eldar6776/Extruder-Raw-Material-Vacuum-Transport-Controller/README.md

# Extruder-Raw-Material-Vacuum-Transport-Controller
Extruder Raw Material Vacuum Transport Controller (PIC16F1517 + PIC12C508)
