eldar6776/Extruder-Raw-Material-Vacuum-Transport-Controller/doc/Kodovi grešaka.png

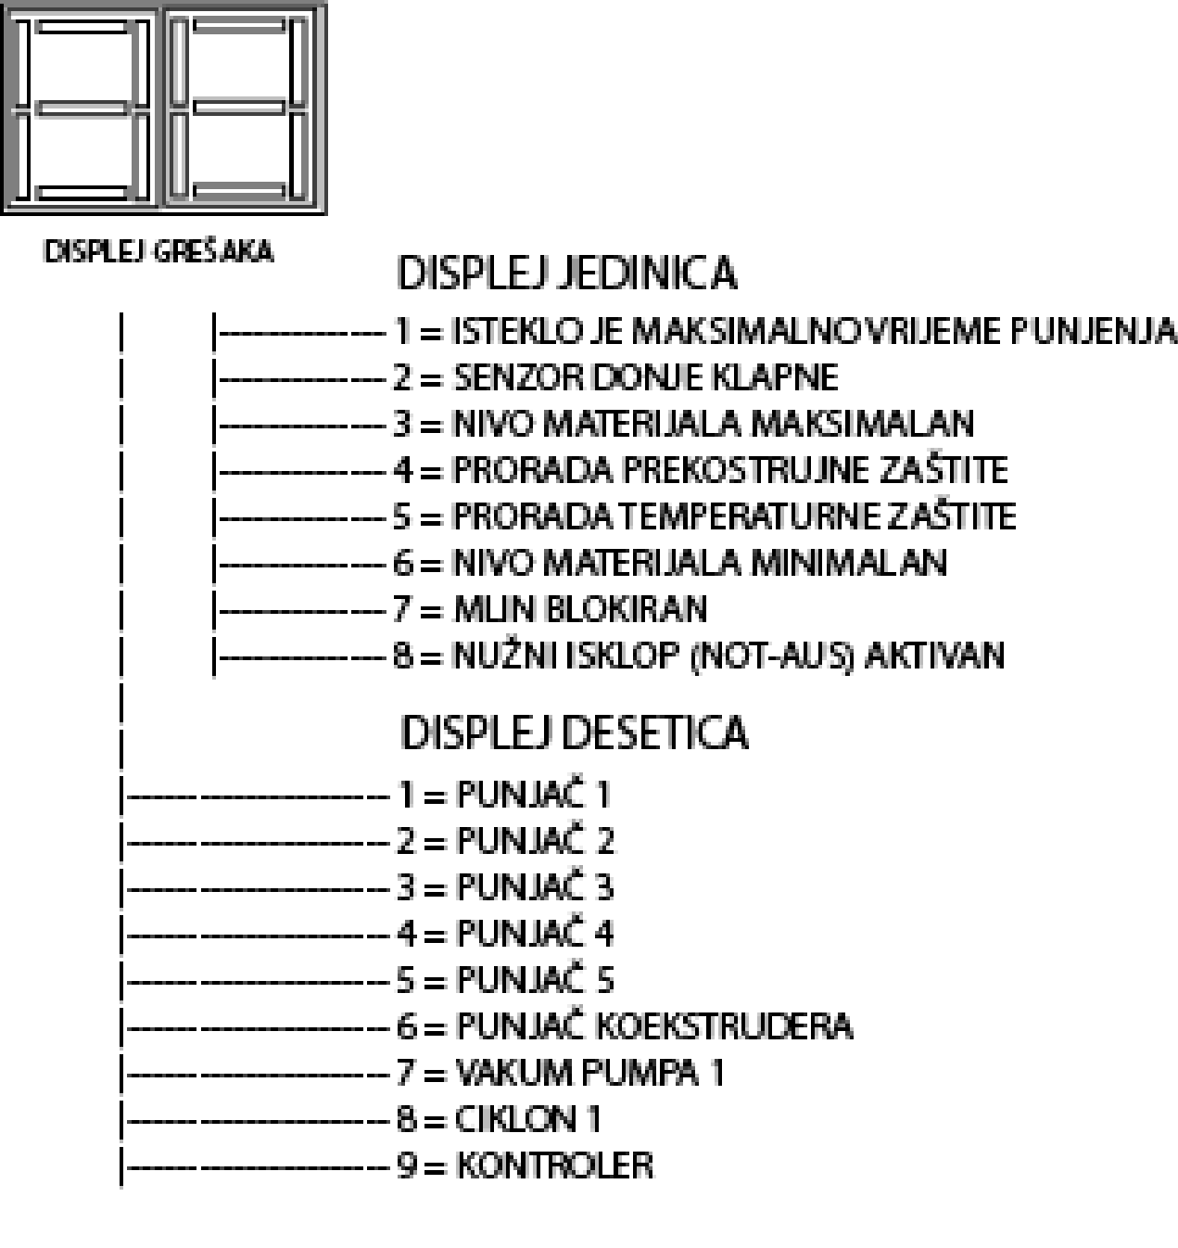
doc/Kodovi grešaka.png
