eldar6776/Extruder-Raw-Material-Vacuum-Transport-Controller/doc/Raspored tastera i indikatora komande punjača.png

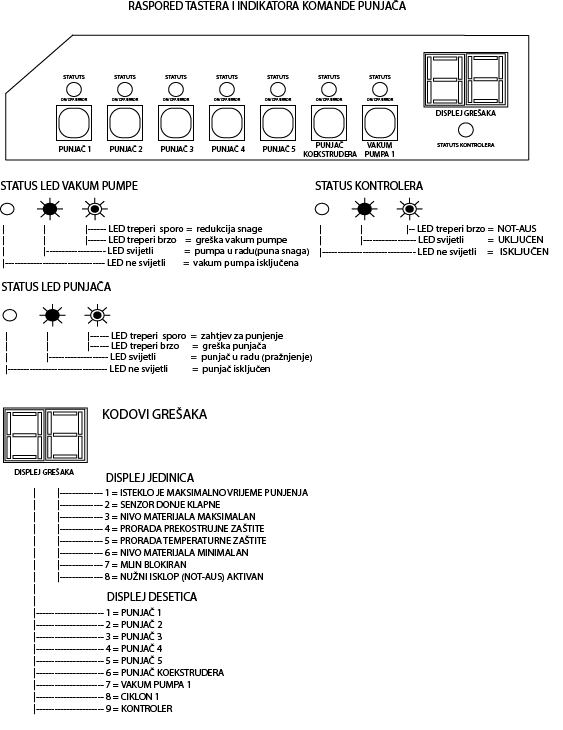
doc/Raspored tastera i indikatora komande punjača.png
