eldar6776/Extruder-Raw-Material-Vacuum-Transport-Controller/doc/TL494_converter.jpg

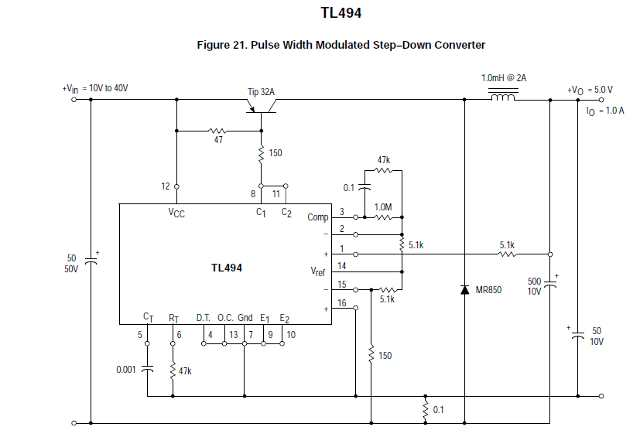
doc/TL494_converter.jpg
