eldar6776/Extruder-Raw-Material-Vacuum-Transport-Controller/(list of files, cad)

Other CAD files:
fw/ERROR_DISPLAY.X/dist/default/production/ERROR_DISPLAY.X.production.obj
fw/ERROR_DISPLAY.X/l.obj
fw/KONTROLER_TRANSPORTA.X/dist/default/production/KONTROLER_TRANSPORTA.X.production.obj
fw/KONTROLER_TRANSPORTA.X/l.obj
