eldar6776/Extruder-Raw-Material-Vacuum-Transport-Controller/DC SUPPLY.PDF

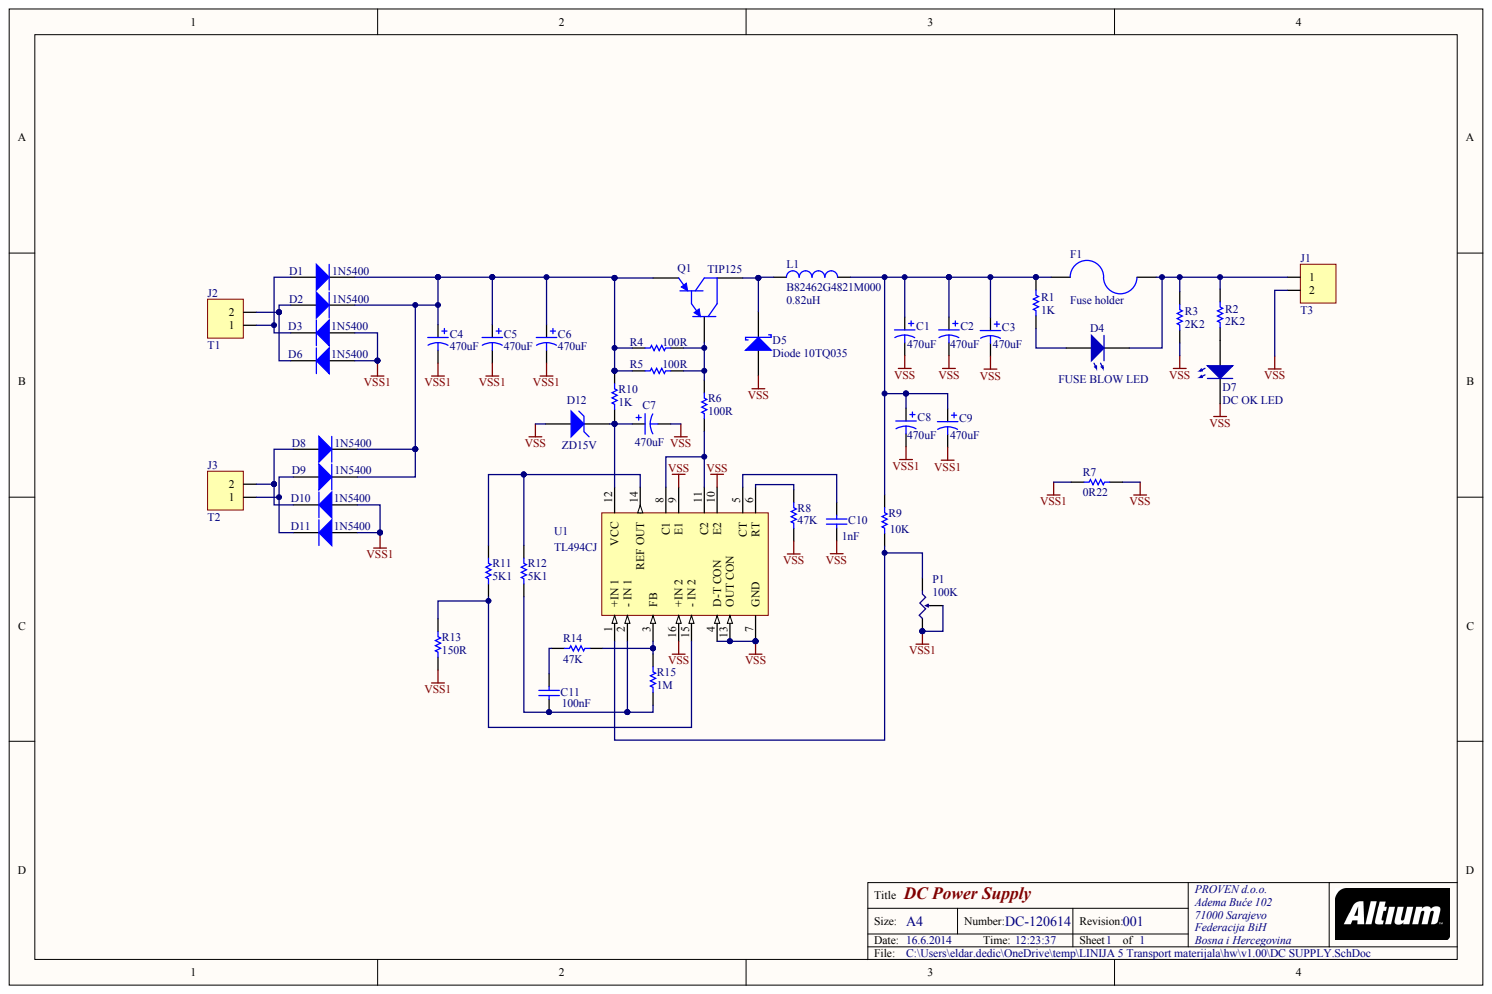
[picture p5: page 1]

DC Power Supply Title | PROVEN d.o.o. Adema Bu ć e 102 71000 Saraje v o Federacija BiH Bosna i Herc egovina

A4 Siz e : | DC-120614 Number: | 001 Revision:
Date : 16.6.2014 Time : 12:23:37 | | She e t 1 of 1

C:\Users\eldar.dedic\OneDrive\temp\LINIJA 5 Transport materijala\hw\v1.00\DC SUPPLY.SchDoc
File

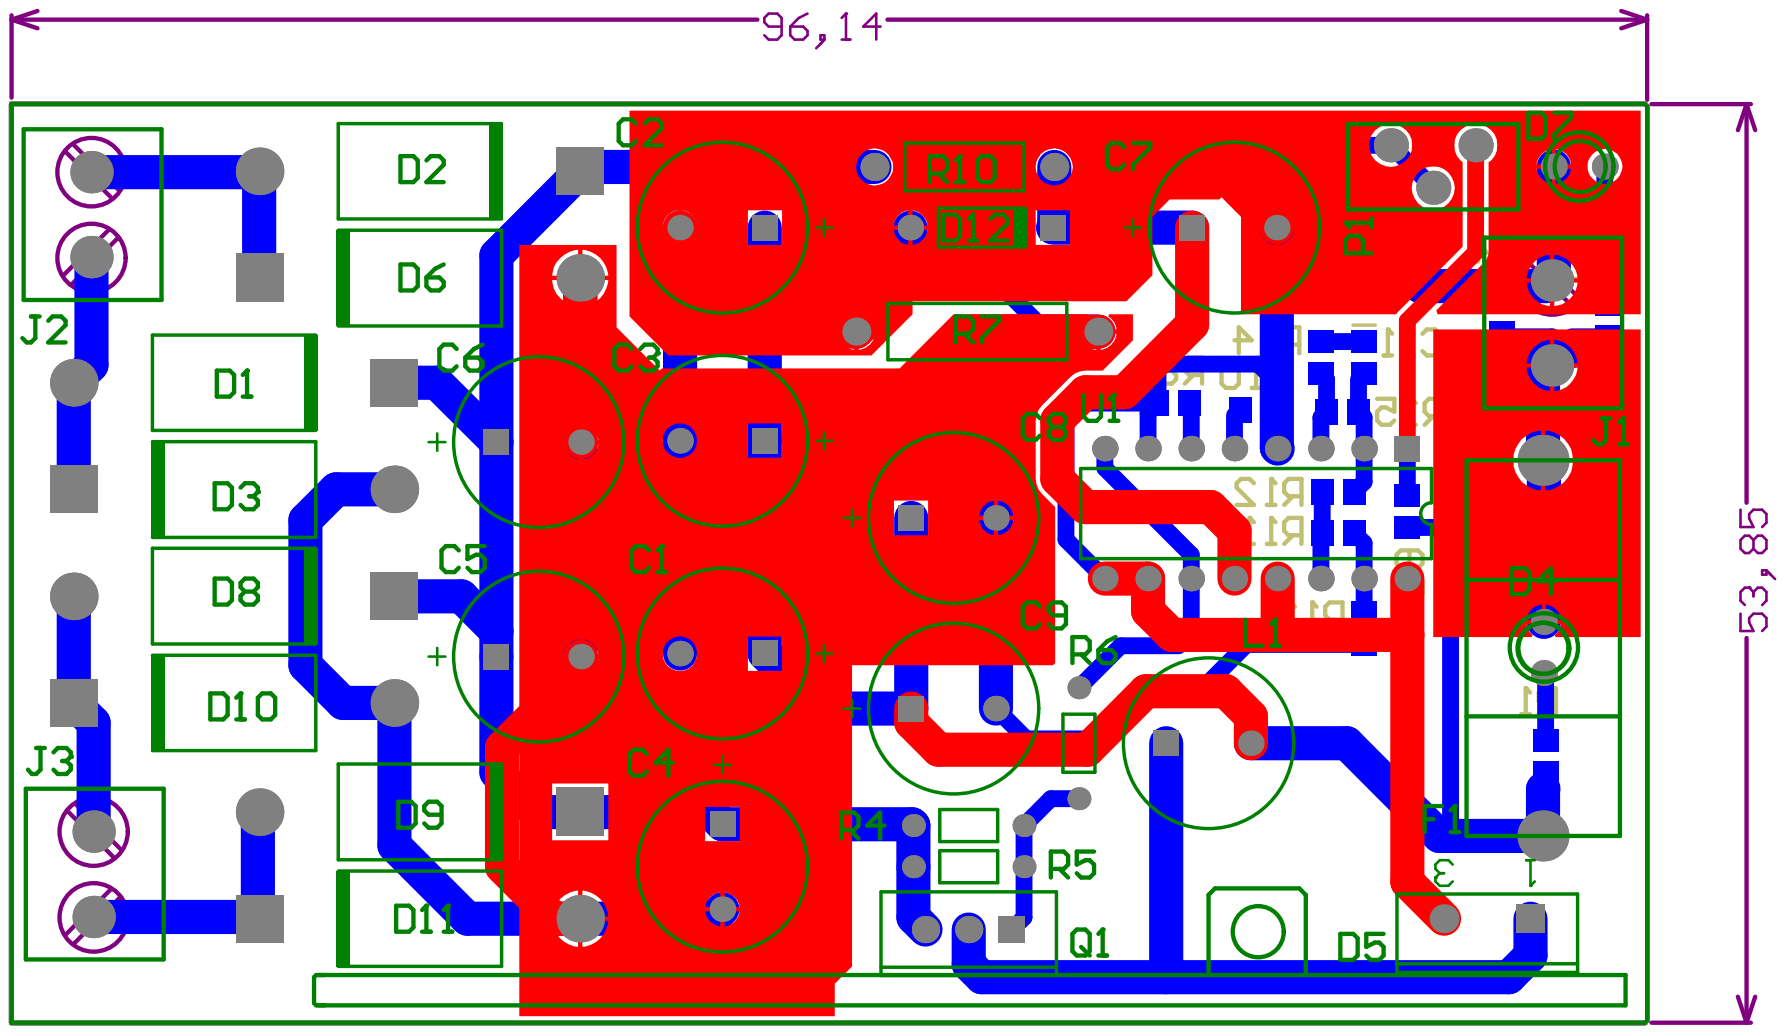
[picture p6: page 2]
