eldar6776/Extruder-Raw-Material-Vacuum-Transport-Controller/doc/Dodatni moduli.pdf

P704 | 1
P702 | 1

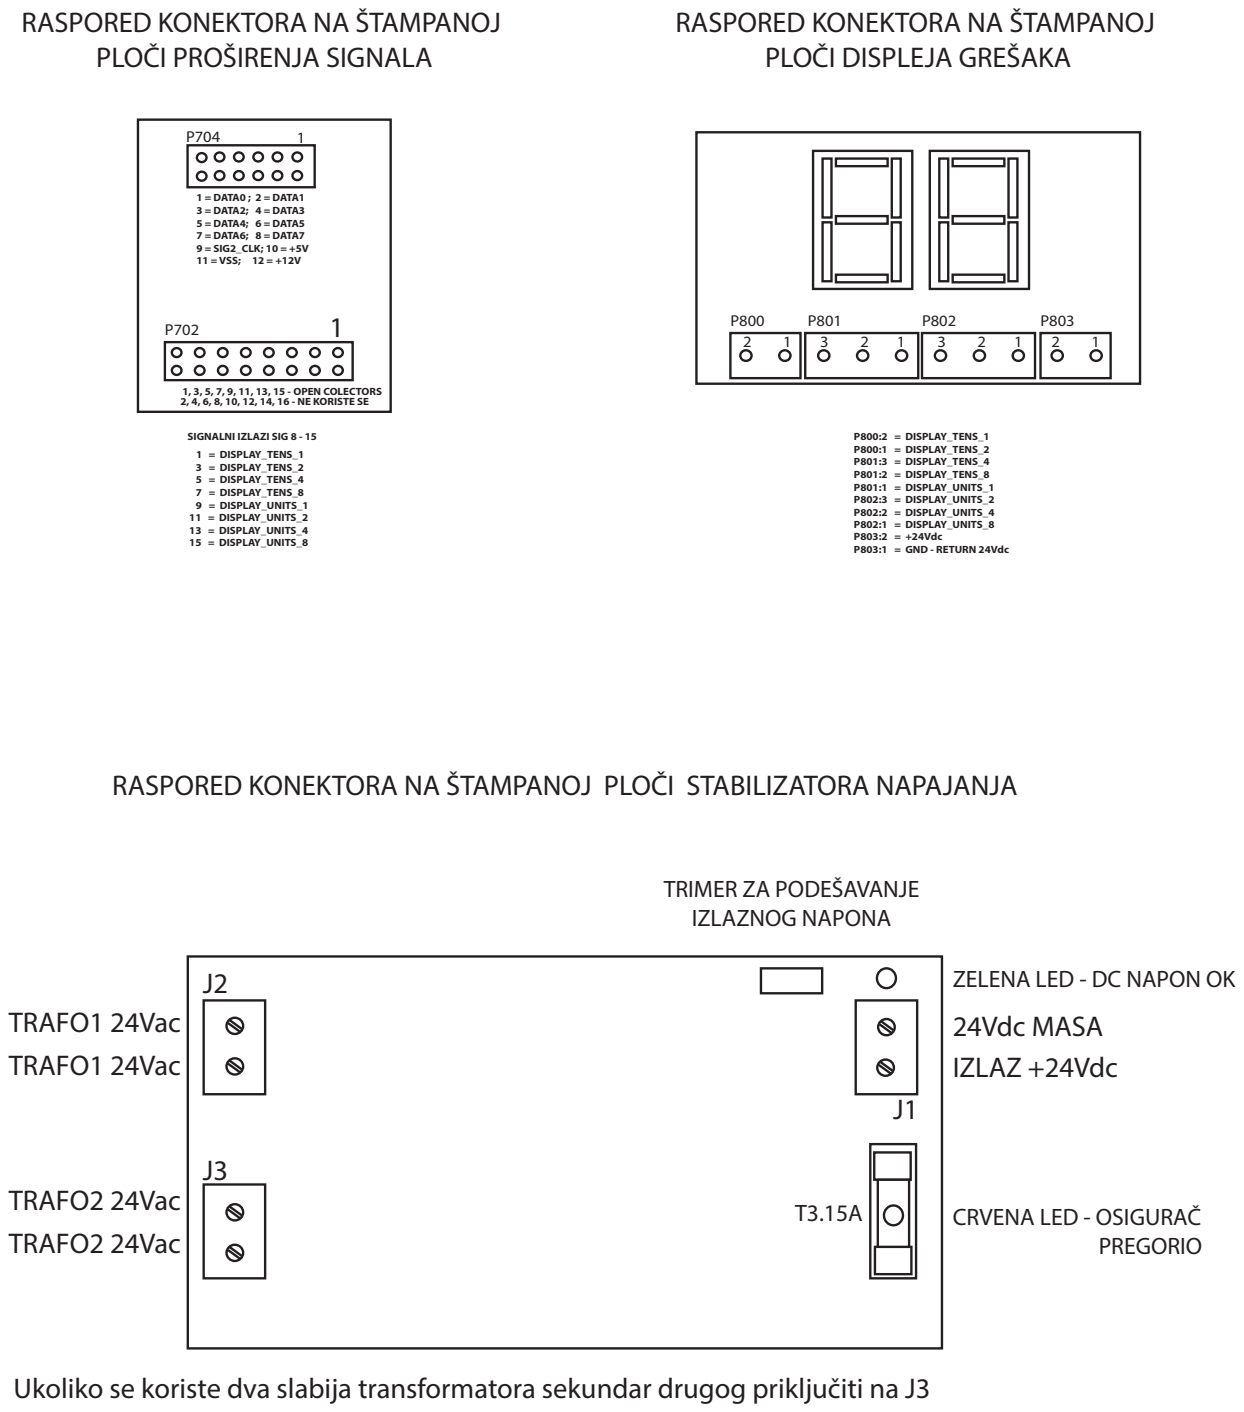
[picture p7: page 1]
1 = DISPLAY_TENS_1; 3 = DISPLAY_TENS_2; 5 = DISPLAY_TENS_4; 7 = DISPLAY_TENS_8; 9 = DISPLAY_UNITS_1; 11 = DISPLAY_UNITS_2; 13 = DISPLAY_UNITS_4; 15 = DISPLAY_UNITS_8; 1 = DATA0 ; 2 = DATA1; 3 = DATA2; 4 = DATA3; 5 = DATA4; 6 = DATA5; 7 = DATA6; 8 = DATA7; 9 = SIG2_CLK; 10 = +5V; 11 = VSS;; P800:2 = DISPLAY_TENS_1; P800:1 = DISPLAY_TENS_2; P801:3 = DISPLAY_TENS_4; P801:2 = DISPLAY_TENS_8; P801:1 = DISPLAY_UNITS_1; P802:3 = DISPLAY_UNITS_2; P802:2 = DISPLAY_UNITS_4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

RASPORED KONEKTORA NA ŠTAMPANOJ
PLOČI PROŠIRENJA SIGNALA

PLOČI DISPLEJA GREŠAKA

1, 3, 5, 7, 9, 11, 13, 15 - OPEN COLECTORS
2, 4, 6, 8, 10, 12, 14, 16 - NE KORISTE SE

SIGNALNI IZLAZI SIG 8 - 15

RASPORED KONEKTORA NA ŠTAMPANOJ PLOČI STABILIZATORA NAPAJANJA

TRIMER ZA PODEŠAVANJE
IZLAZNOG NAPONA

ZELENA LED - DC NAPON OK
24Vdc MASA
IZLAZ +24Vdc

CRVENA LED - OSIGURAČ

Ukoliko se koriste dva slabija transformatora sekundar drugog priključiti na J3
