eldar6776/Extruder-Raw-Material-Vacuum-Transport-Controller/doc/Raspored tastera i indikatora komande punjača.pdf

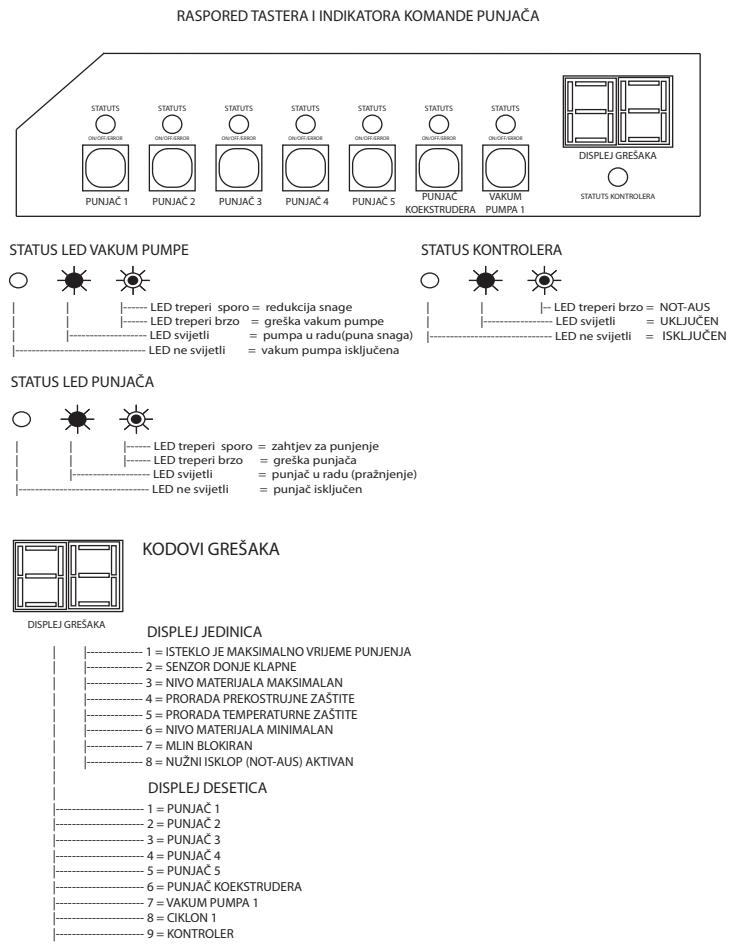
[picture p8: page 1]
PUNJAČ 1; PUNJAČ 2; PUNJAČ 3; PUNJAČ 4; PUNJAČ 5; PUNJAČ; KOEKSTRUDERA; VAKUM PUMPA 1; DISPLEJ GREŠAKA; STATUTS; STATUTS KONTROLERA; ON/OFF/ERROR; |-------------- 1 = ISTEKLO JE MAKSIMALNO VRIJEME PUNJENJA; |-------------- 2 = SENZOR DONJE KLAPNE; |-------------- 3 = NIVO MATERIJALA MAKSIMALAN; |-------------- 4 = PRORADA PREKOSTRUJNE ZAŠTITE; |-------------- 5 = PRORADA TEMPERATURNE ZAŠTITE; |-------------- 6 = NIVO MATERIJALA MINIMALAN; |-------------- 7 = MLIN BLOKIRAN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

RASPORED TASTERA I INDIKATORA KOMANDE PUNJAČA

STATUS LED VAKUM PUMPE

STATUS LED PUNJAČA

------------------------------ LED ne svijetli = ISKLJUČEN
