eldar6776/Extruder-Raw-Material-Vacuum-Transport-Controller/doc/Aux_PCB_print.pdf

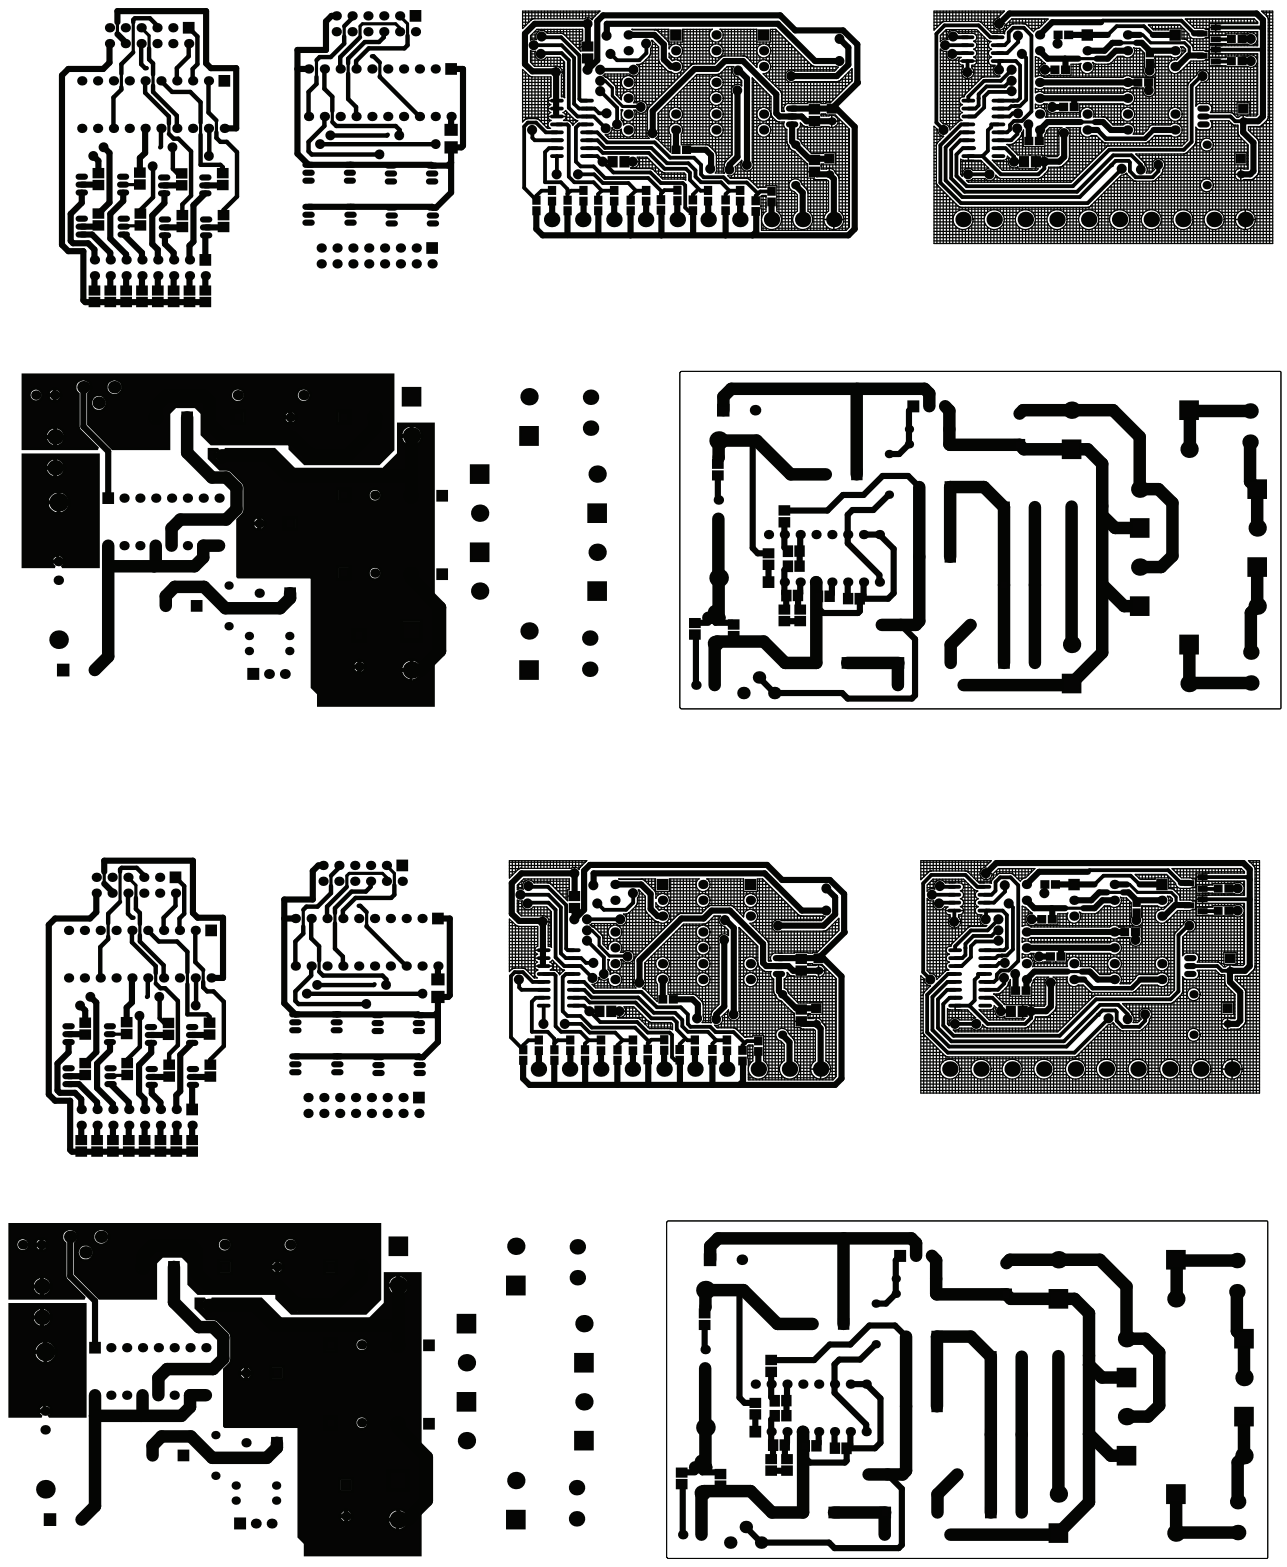
[picture p9: page 1]
