eldar6776/Extruder-Raw-Material-Vacuum-Transport-Controller/KOTROLER_TRANSPORTA.PDF

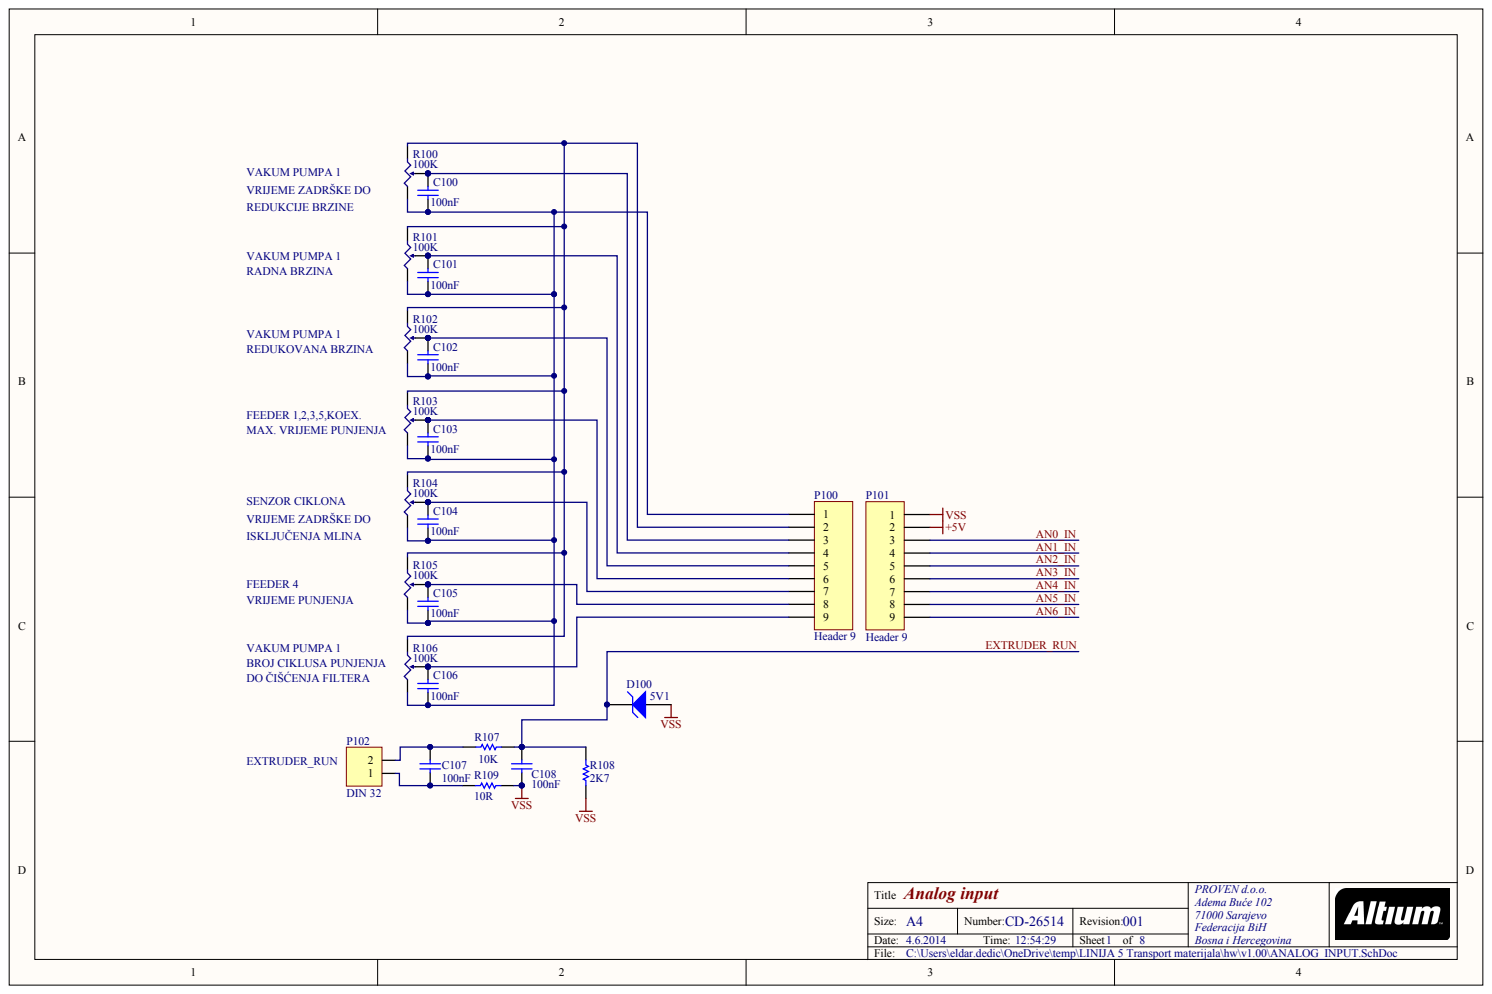
[picture p35: page 1]

Analog input Title | PROVEN d.o.o. Adema Bu ć e 102 71000 Saraje v o Federacija BiH Bosna i Herc egovina

A4 Siz e : | CD-26514 Number: | 001 Revision:
Date : 4.6.2014 Time : 12:54:29 | | She e t of 8

C:\Users\eldar.dedic\OneDrive\temp\LINIJA 5 Transport materijala\hw\v1.00\ANALOG_INPUT.SchDoc
File

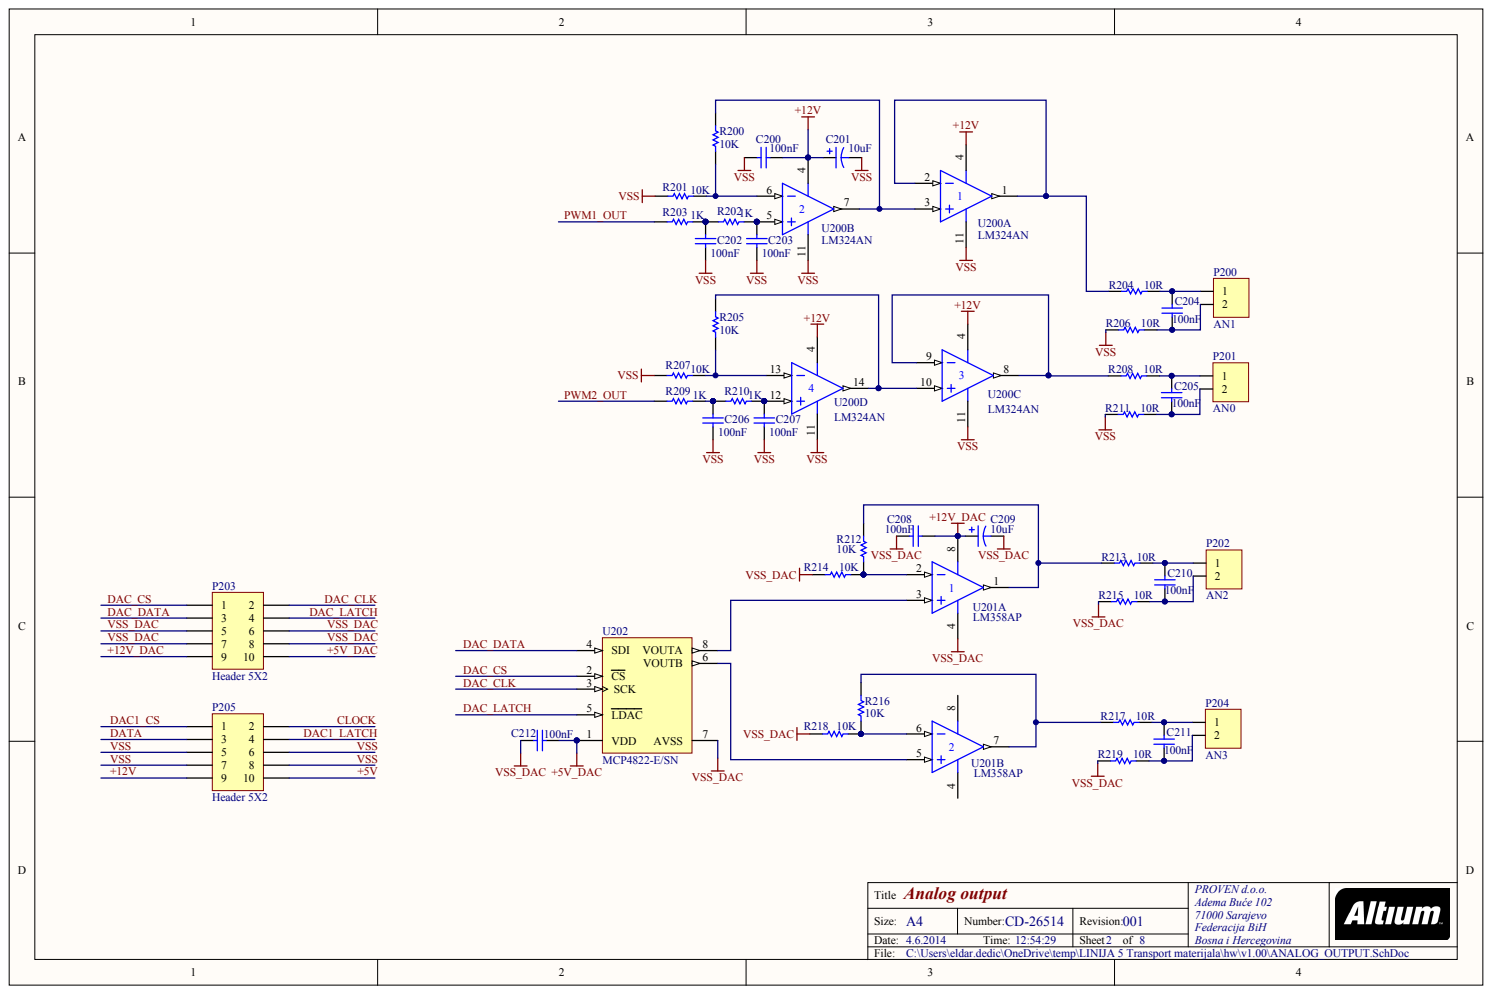
[picture p36: page 2]
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

A4 Siz e : | Number: | Revision:
Date : Time : | | She t of 8

C:\Users\eldar.dedic\OneDrive\temp\LINIJA 5 Transport materijala\hw\v1.00\ANALOG_OUTPUT.SchDoc
File

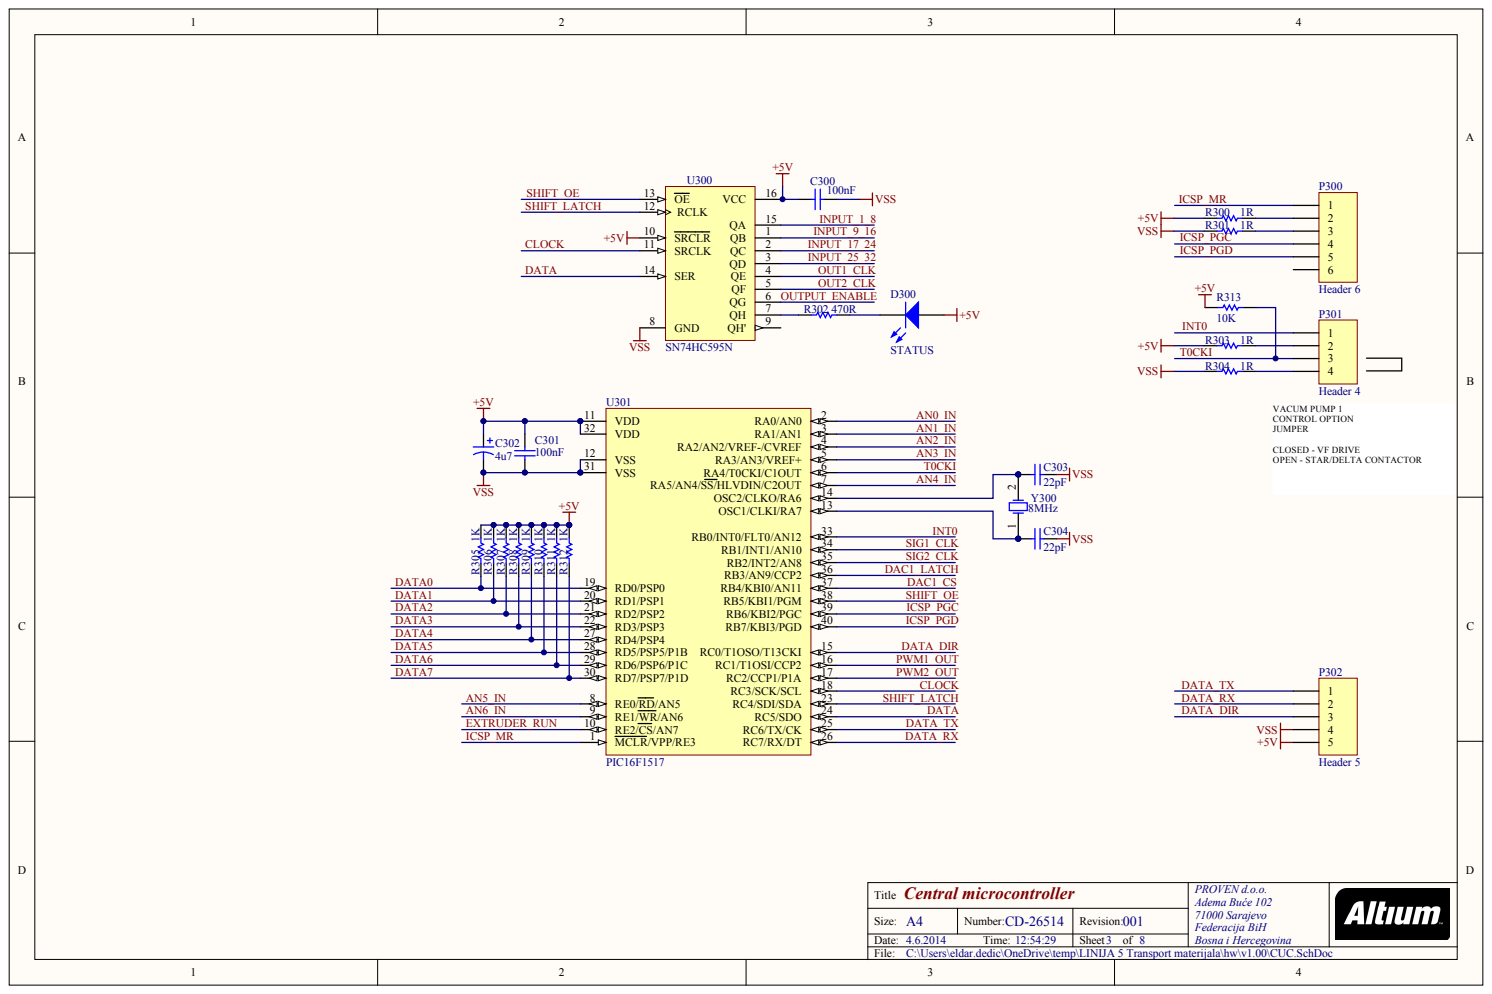
[picture p37: page 3]

VDD 32 | 3 AN1_IN
VSS 12 | 4 AN2_IN

VSS 31 | 6 T0CKI
RD0/PSP0 19 RD1/PSP1 20 RD2/PSP2 21 RD3/PSP3 22 RD4/PSP4 27 RD5/PSP5/P1B 28 RD6/PSP6/P1C 29 RD7/PSP7/P1D 30 RE2/CS/AN7 10 | 7 | AN4_IN

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

A4 Siz e : | Number: | Revision:
Date : Time : | | She t of 8

C:\Users\eldar.dedic\OneDrive\temp\LINIJA 5 Transport materijala\hw\v1.00\CUC.SchDoc
File

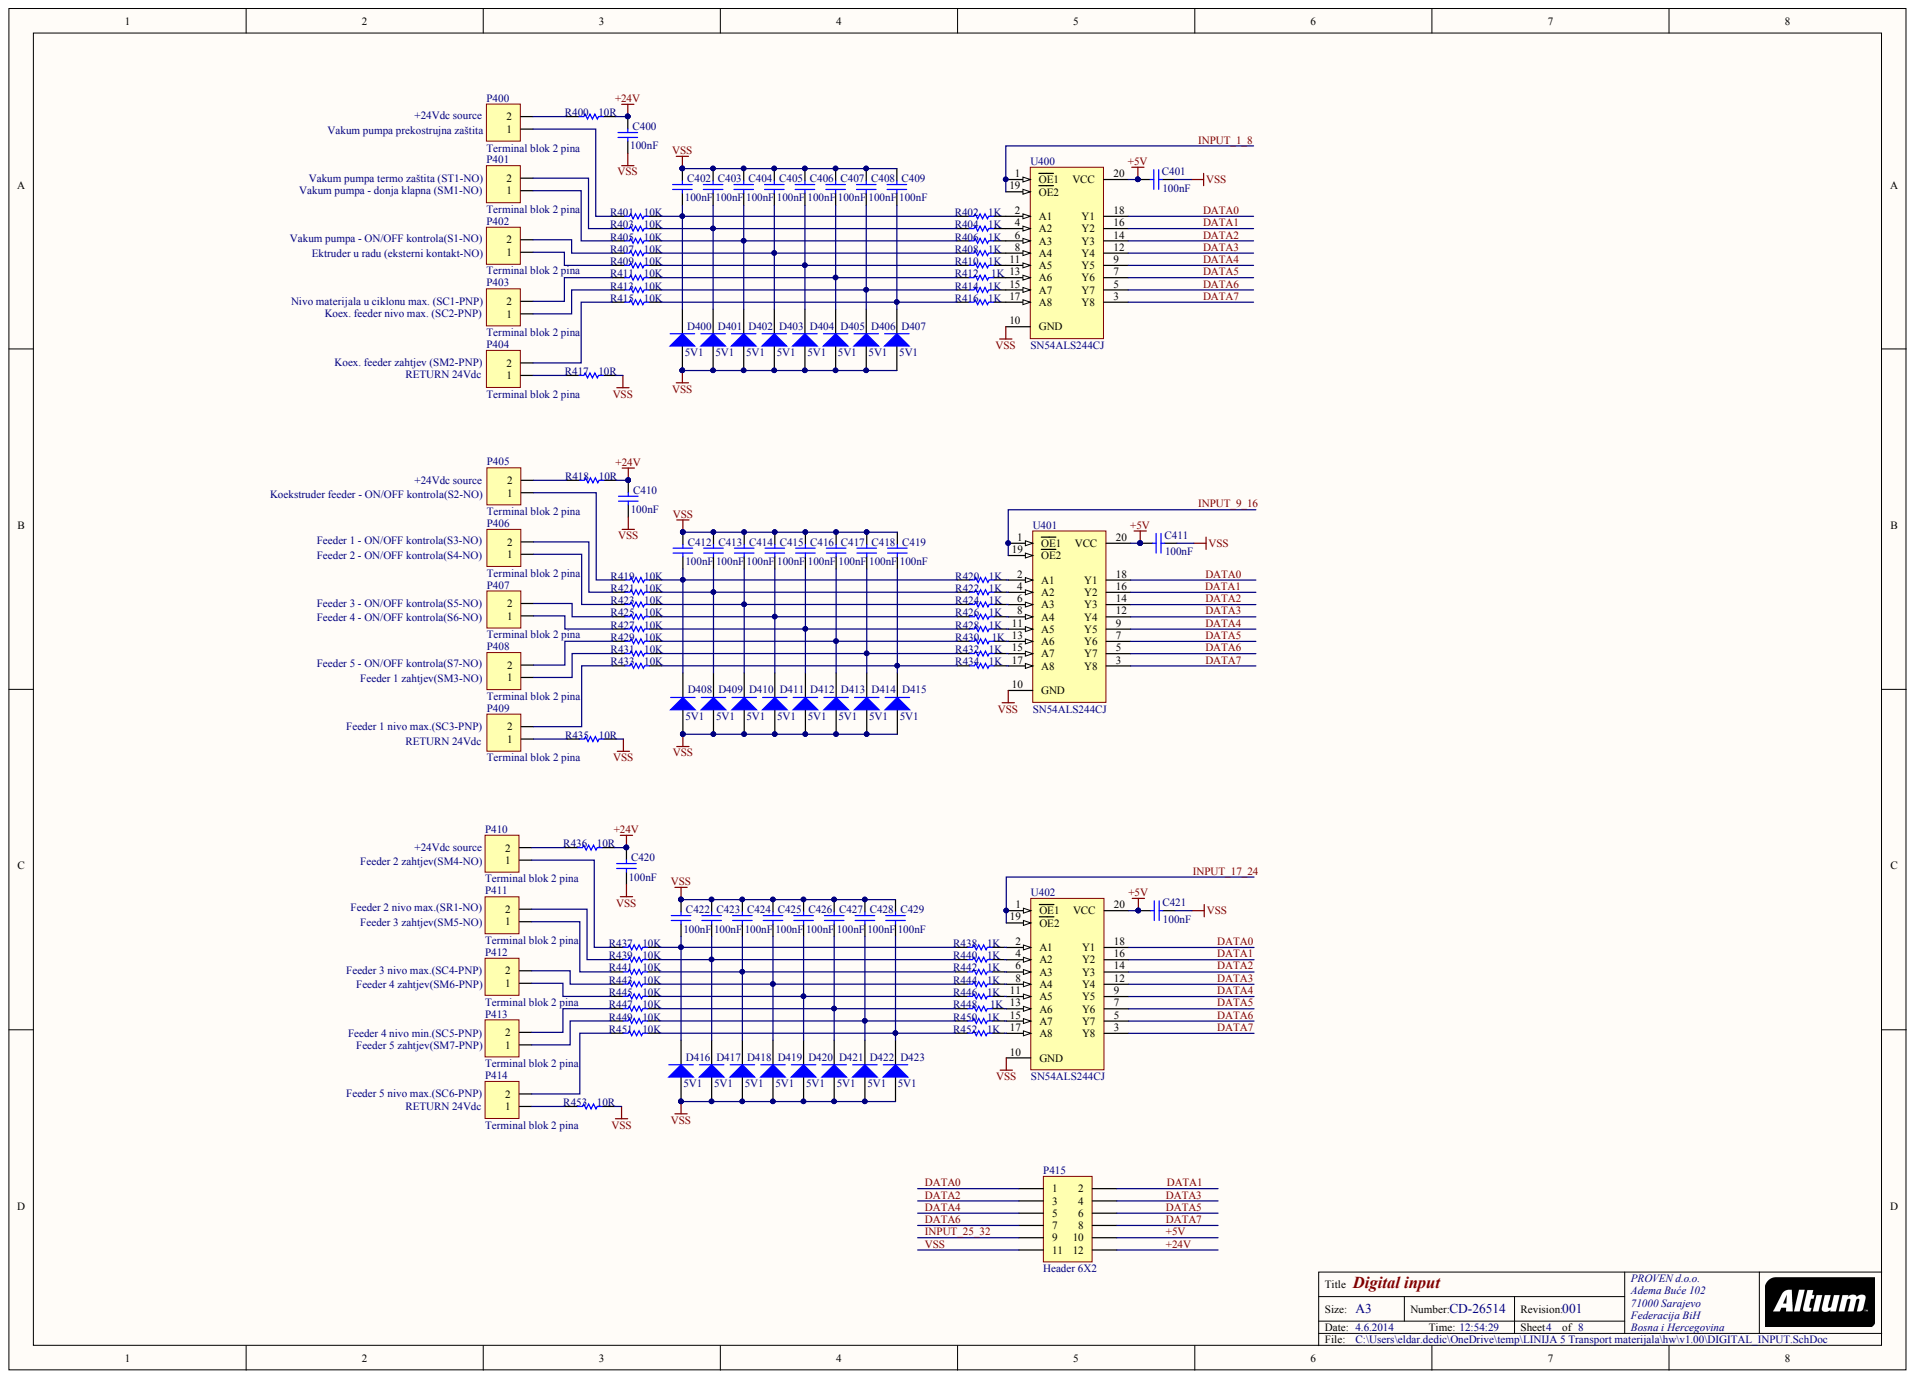
[picture p38: page 4]

Vakum pumpa prekostrujna zaštita

Vakum pumpa termo zaštita (ST1-NO)
Vakum pumpa - donja klapna (SM1-NO)

Vakum pumpa - ON/OFF kontrola(S1-NO)
Ektruder u radu (eksterni kontakt-NO)

Nivo materijala u ciklonu max. (SC1-PNP)

Koex. feeder nivo max. (SC2-PNP)

Koex. feeder zahtjev (SM2-PNP)

Koekstruder feeder - ON/OFF kontrola(S2-NO)

Feeder 1 - ON/OFF kontrola(S3-NO)
Feeder 2 - ON/OFF kontrola(S4-NO)

Feeder 3 - ON/OFF kontrola(S5-NO)
Feeder 4 - ON/OFF kontrola(S6-NO)

Feeder 5 - ON/OFF kontrola(S7-NO)

Feeder 1 nivo max.(SC3-PNP)

Feeder 3 nivo max.(SC4-PNP)
Feeder 4 zahtjev(SM6-PNP)

Feeder 4 nivo min.(SC5-PNP)
Feeder 5 zahtjev(SM7-PNP)

Feeder 5 nivo max.(SC6-PNP)

Title Digital input | PROVEN d.o.o. Adema Buće 102 71000 Sarajevo Federacija BiH Bosna i Hercegovina

Size: A3 | Number: CD-26514 | Revision: 001

Date: Time: | | Sheet of 8

C:\Users\eldar.dedic\OneDrive\temp\LINIJA 5 Transport materijala\hw\v1.00\DIGITAL_INPUT.SchDoc

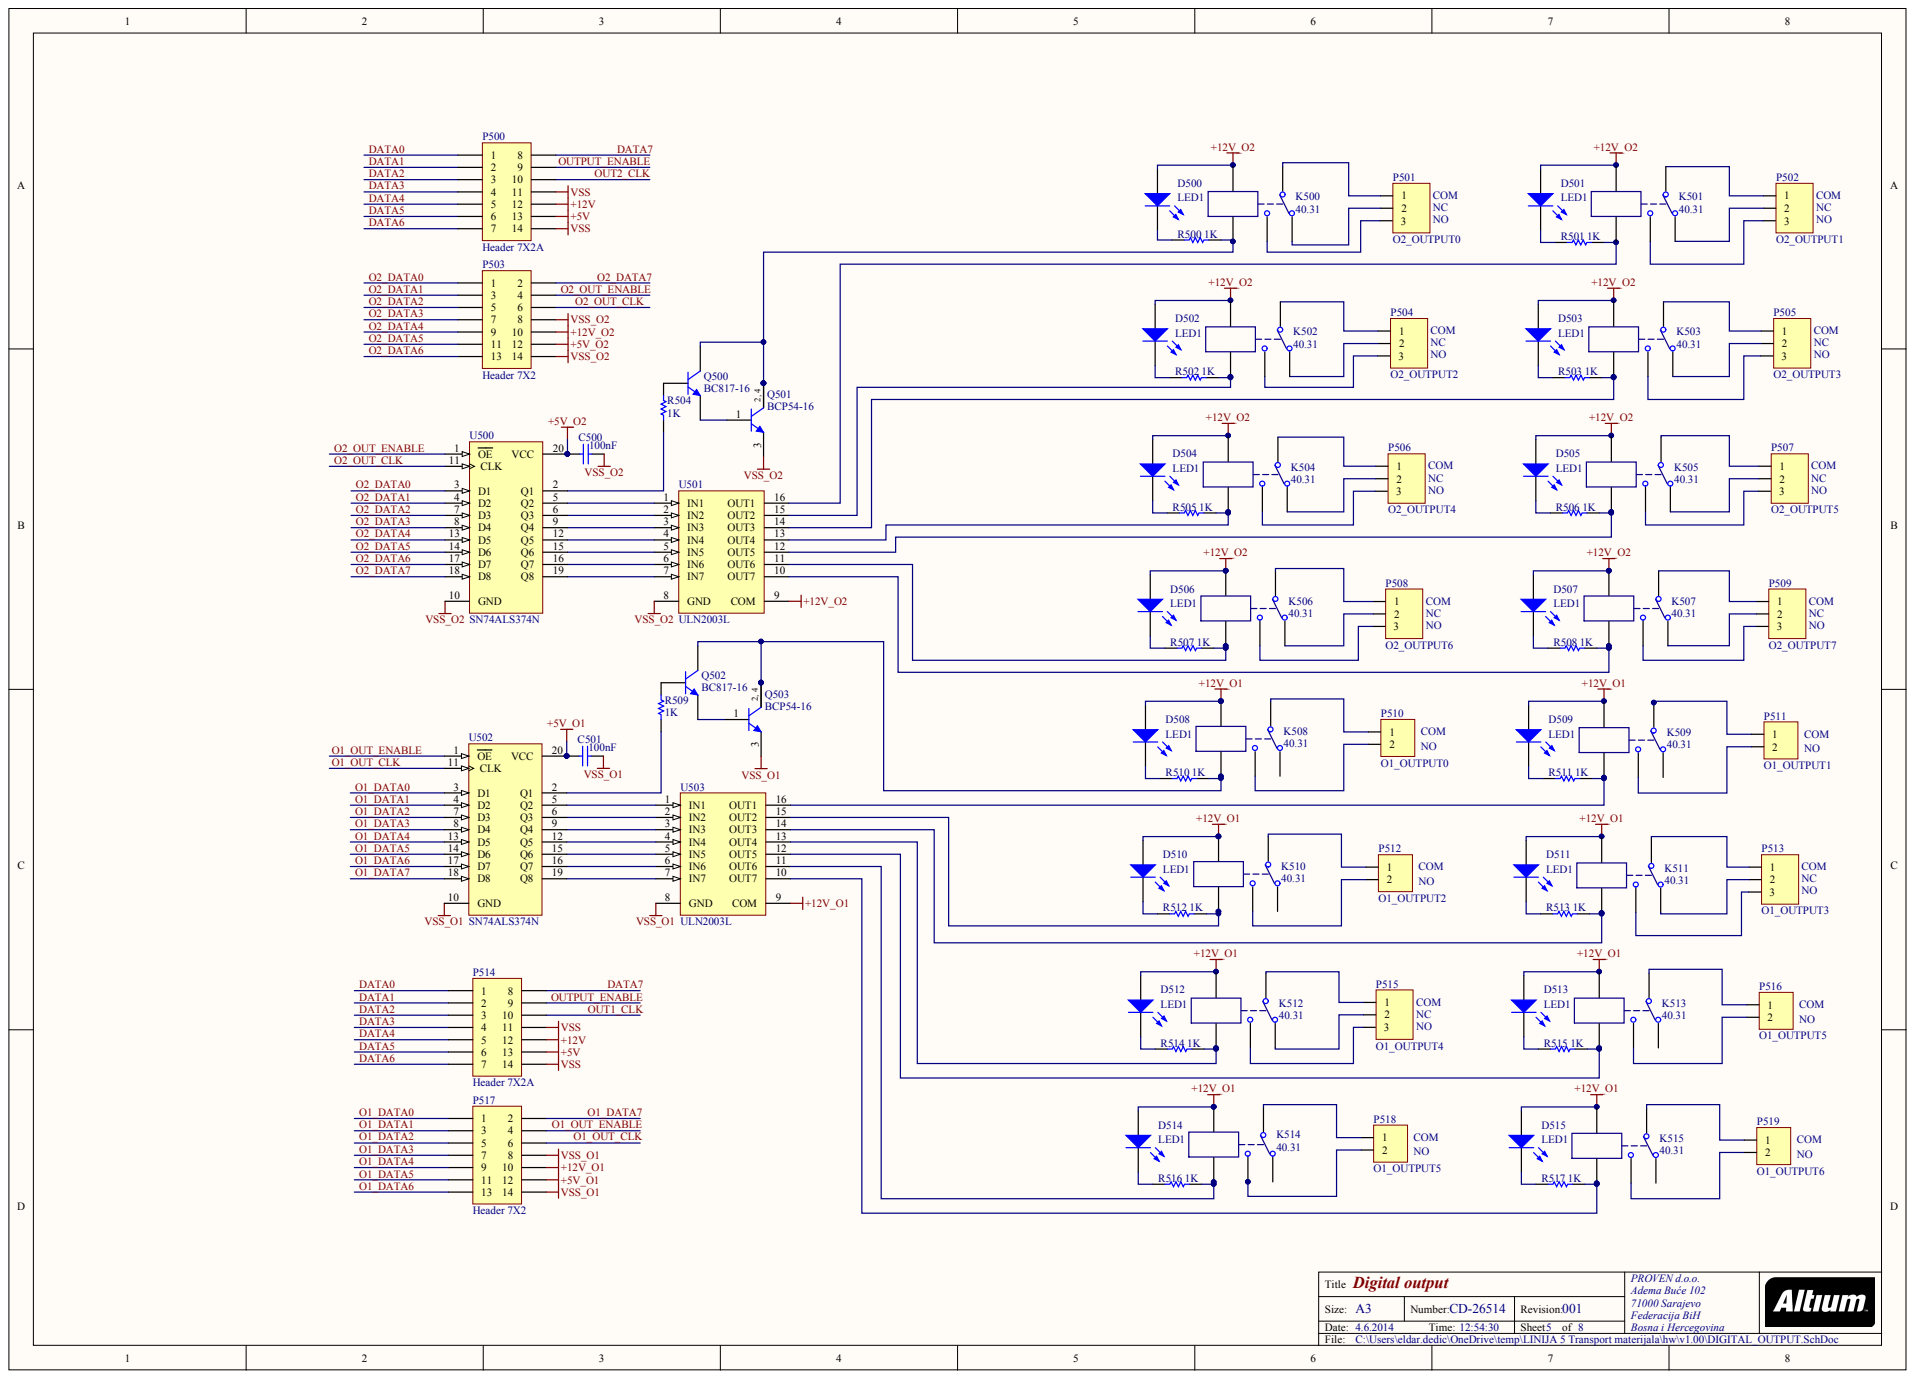
[picture p39: page 5]

Ti t l Digital output | PROVEN d.o.o. Adema Bu će 102 71000 Sarajevo Federacija BiH Bosna i Hercegovina

Size: A3 | Number: CD-26514 | Revision: 001

Ti me: | | Sheet of 8

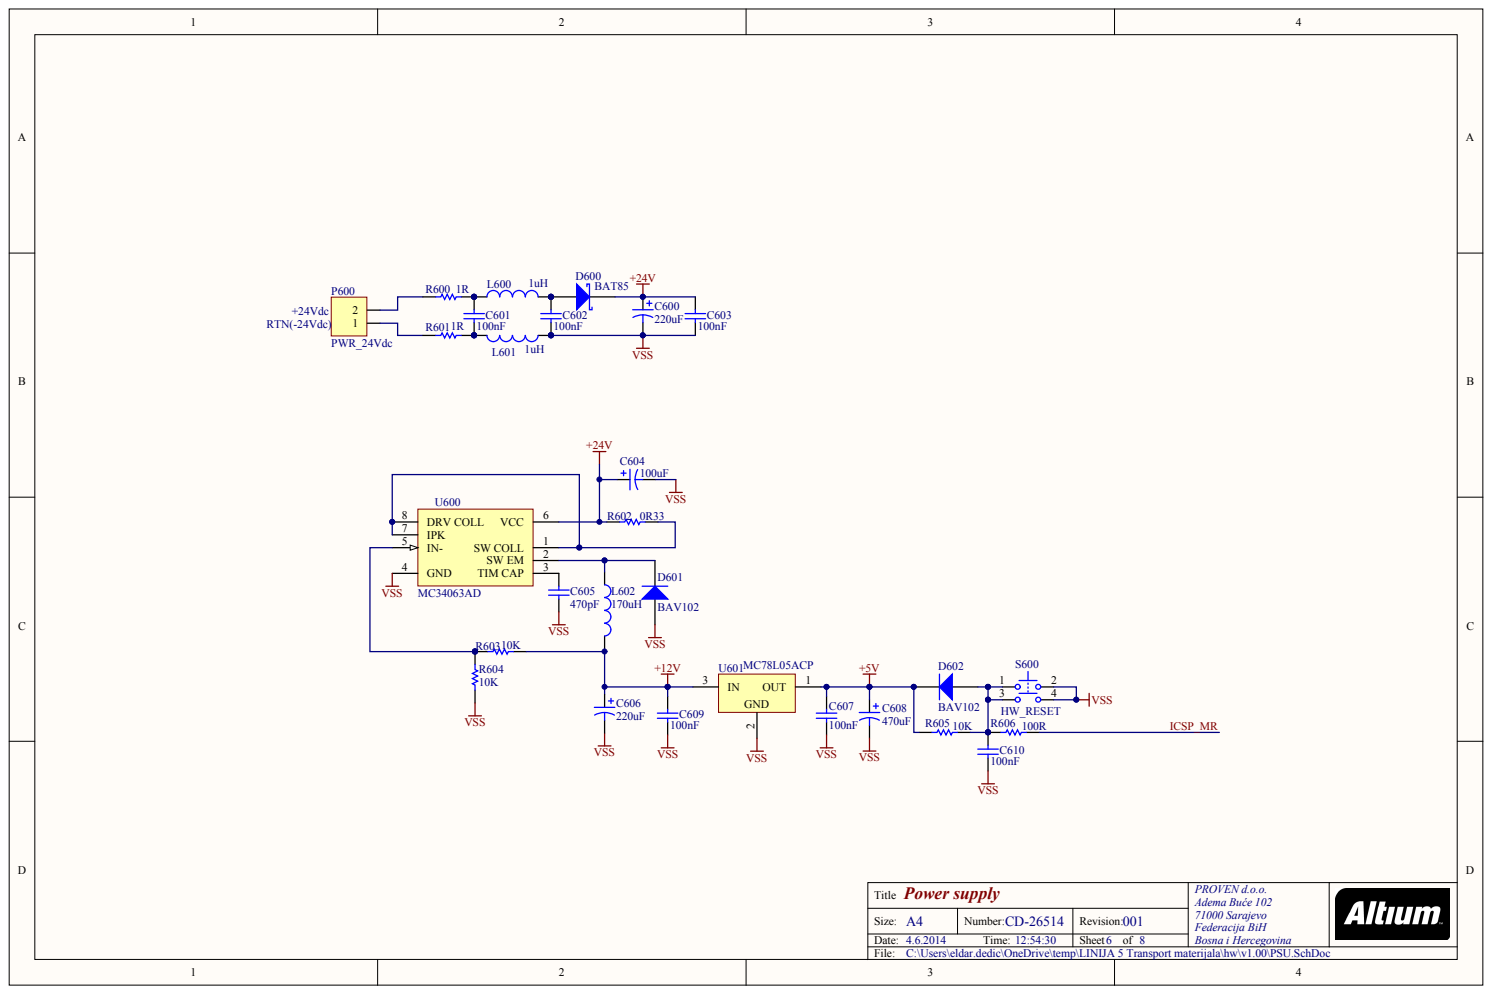
[picture p40: page 6]

Power supply Title | PROVEN d.o.o. Adema Buće 102 71000 Sarajevo Federacija BiH

A4 Size: | CD-26514 Number: | 001 Revision:

C:\Users\eldar.dedic\OneDrive\temp\LINIJA 5 Transport materijala\hw\v1.00\PSU.SchDoc

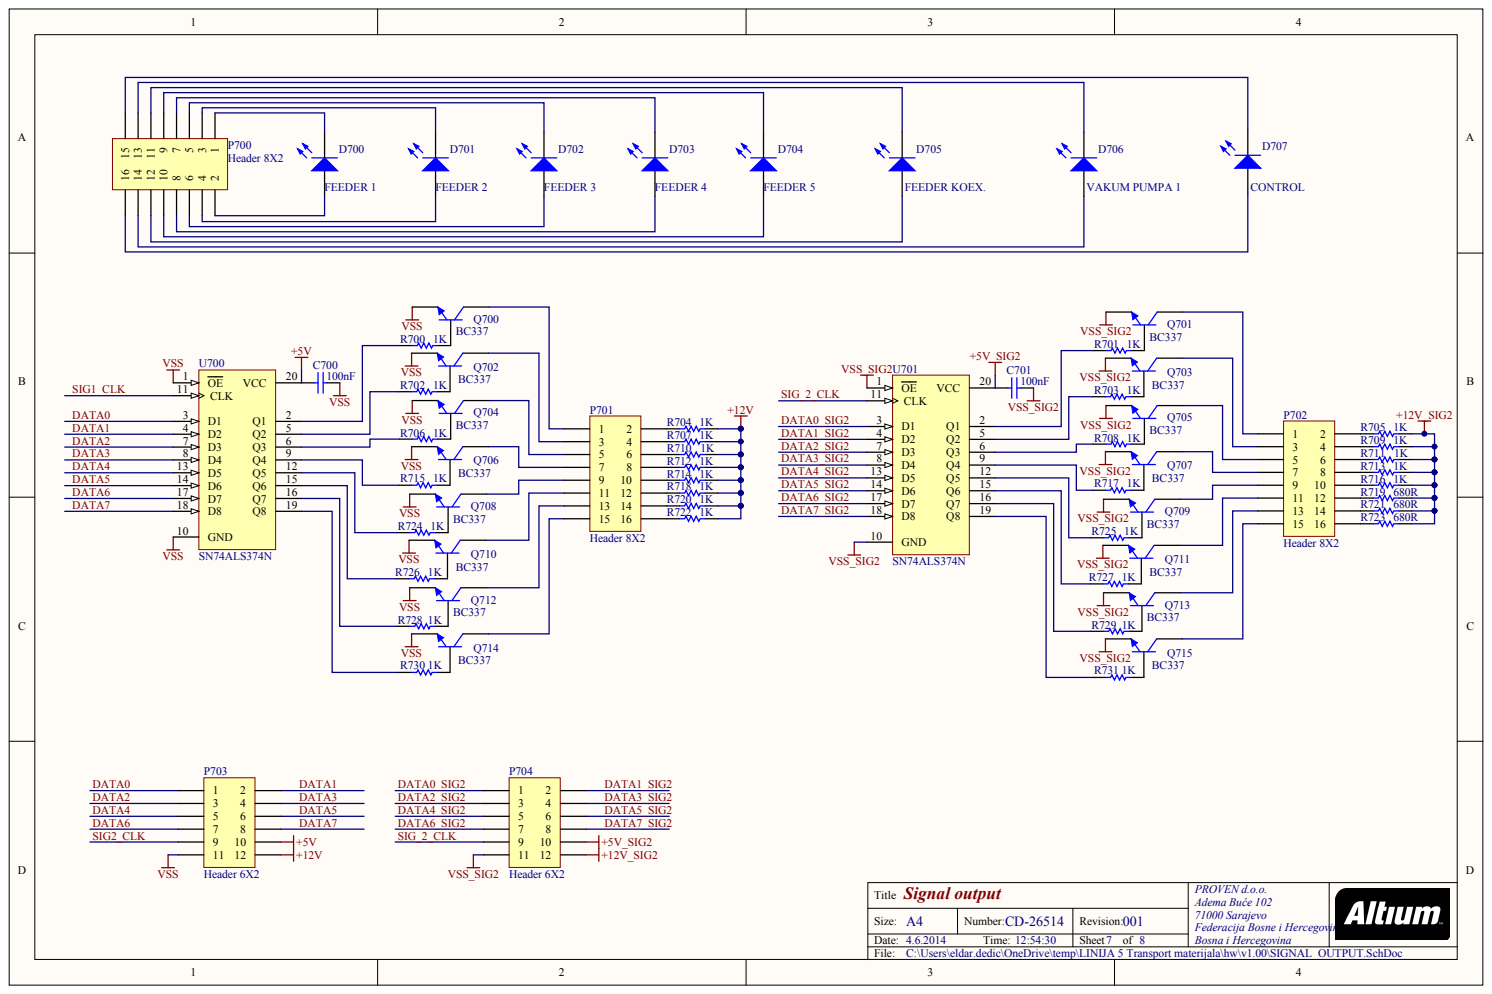
[picture p41: page 7]

Signal output Title | PROVEN d.o.o. Adema Buće 102 71000 Sarajevo Federacija Bosne i Hercegovine

A4 Size: | CD-26514 Number: | 001 Revision:

C:\Users\eldar.dedic\OneDrive\temp\LINIJA 5 Transport materijala\hw\v1.00\SIGNAL_OUTPUT.SchDoc

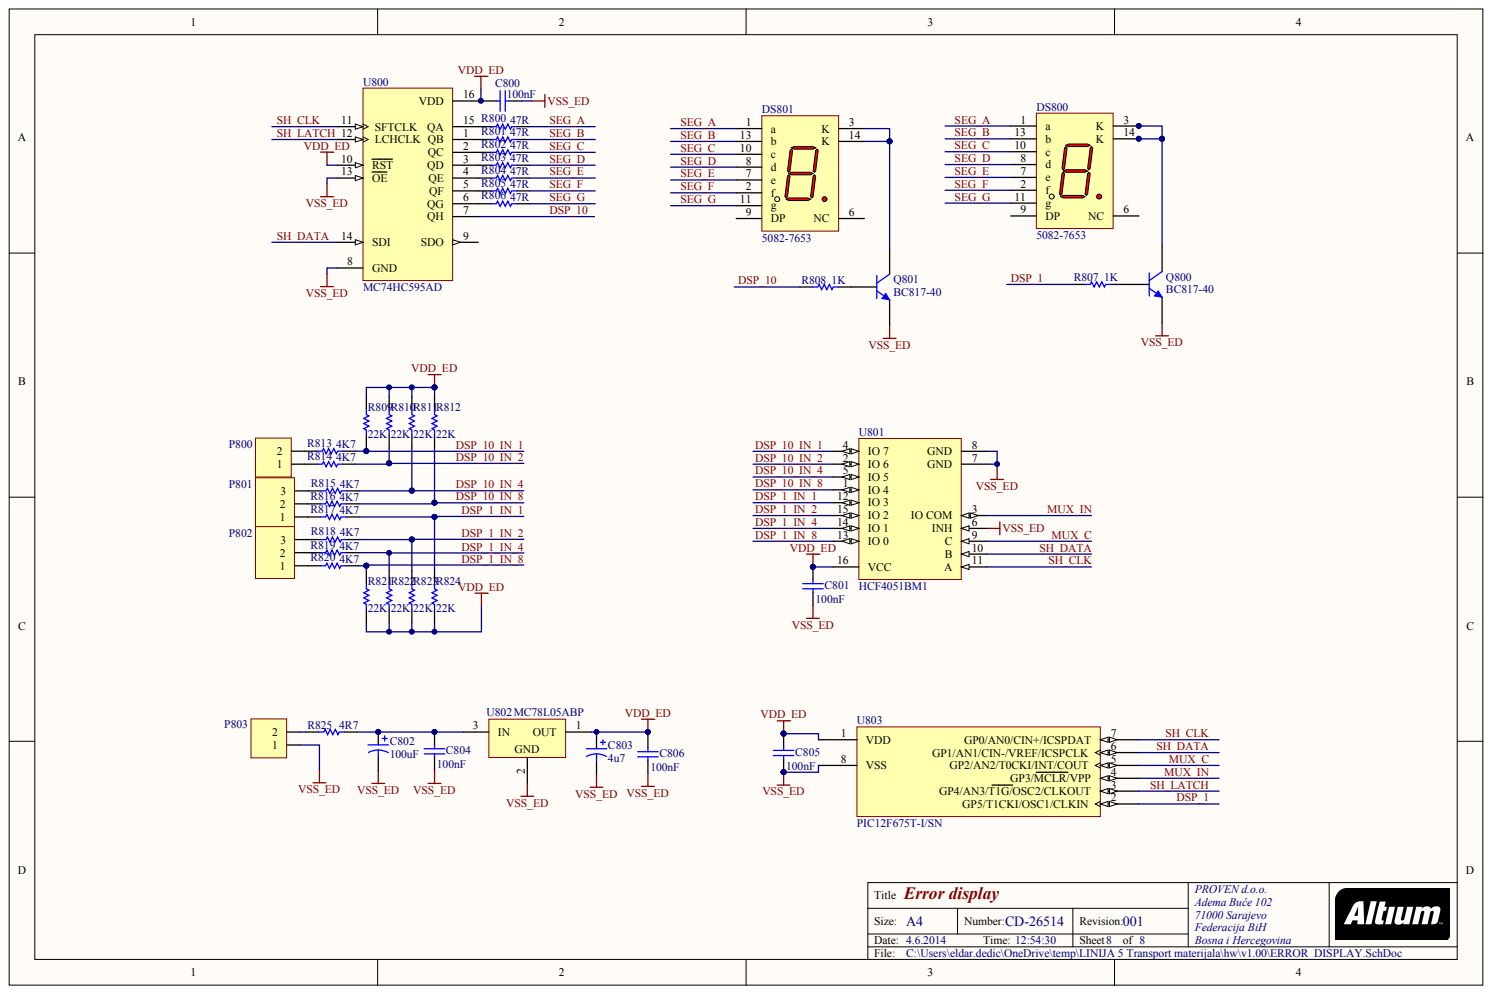
[picture p42: page 8]

Error display Title | PROVEN d.o.o. Adema Buće 102 71000 Sarajevo Federacija BiH

A4 Size: | CD-26514 Number: | 001 Revision:

C:\Users\eldar.dedic\OneDrive\temp\LINIJA 5 Transport materijala\hw\v1.00\ERROR_DISPLAY.SchDoc

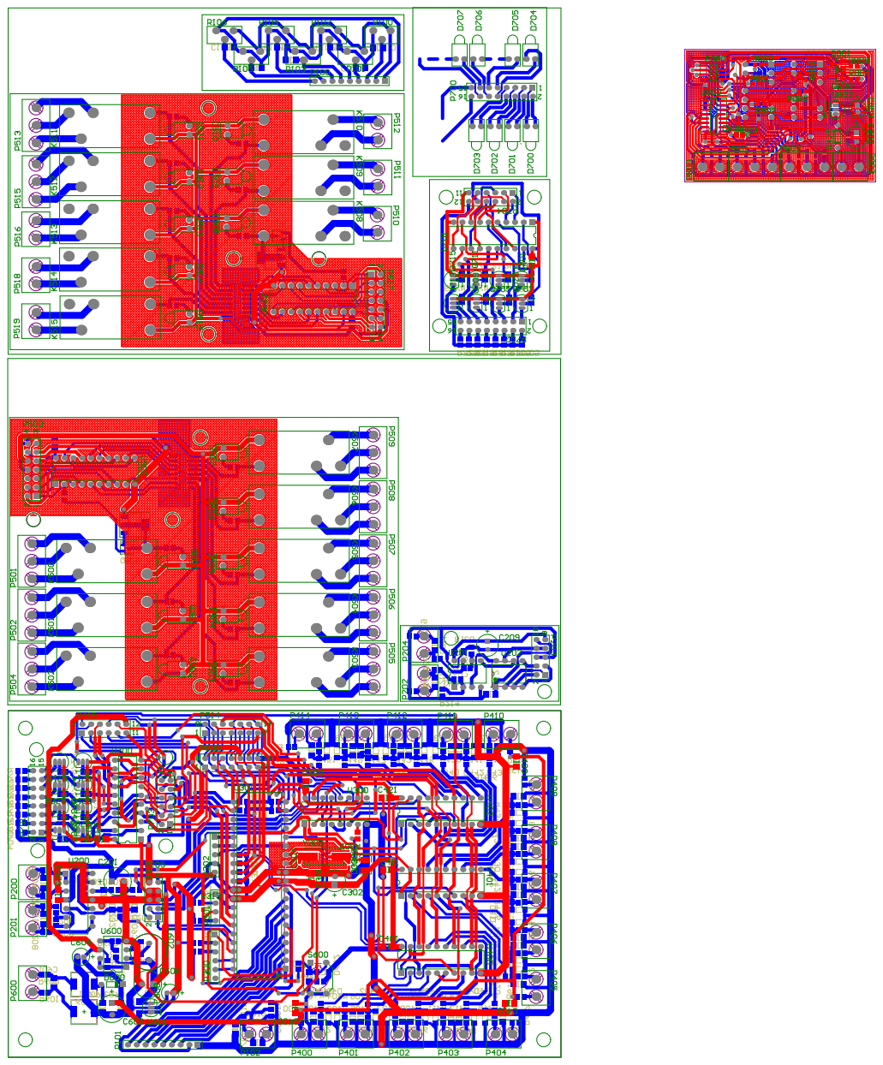
[picture p43: page 9]
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
