eldar6776/Extruder-Raw-Material-Vacuum-Transport-Controller/doc/Raspored konektora na štampanim pločama relejnih modula.pdf

# RASPOERED KONEKTORA NA ŠTAMPANOJ PLOČI RELEJNIH IZLAZA 0 - 7

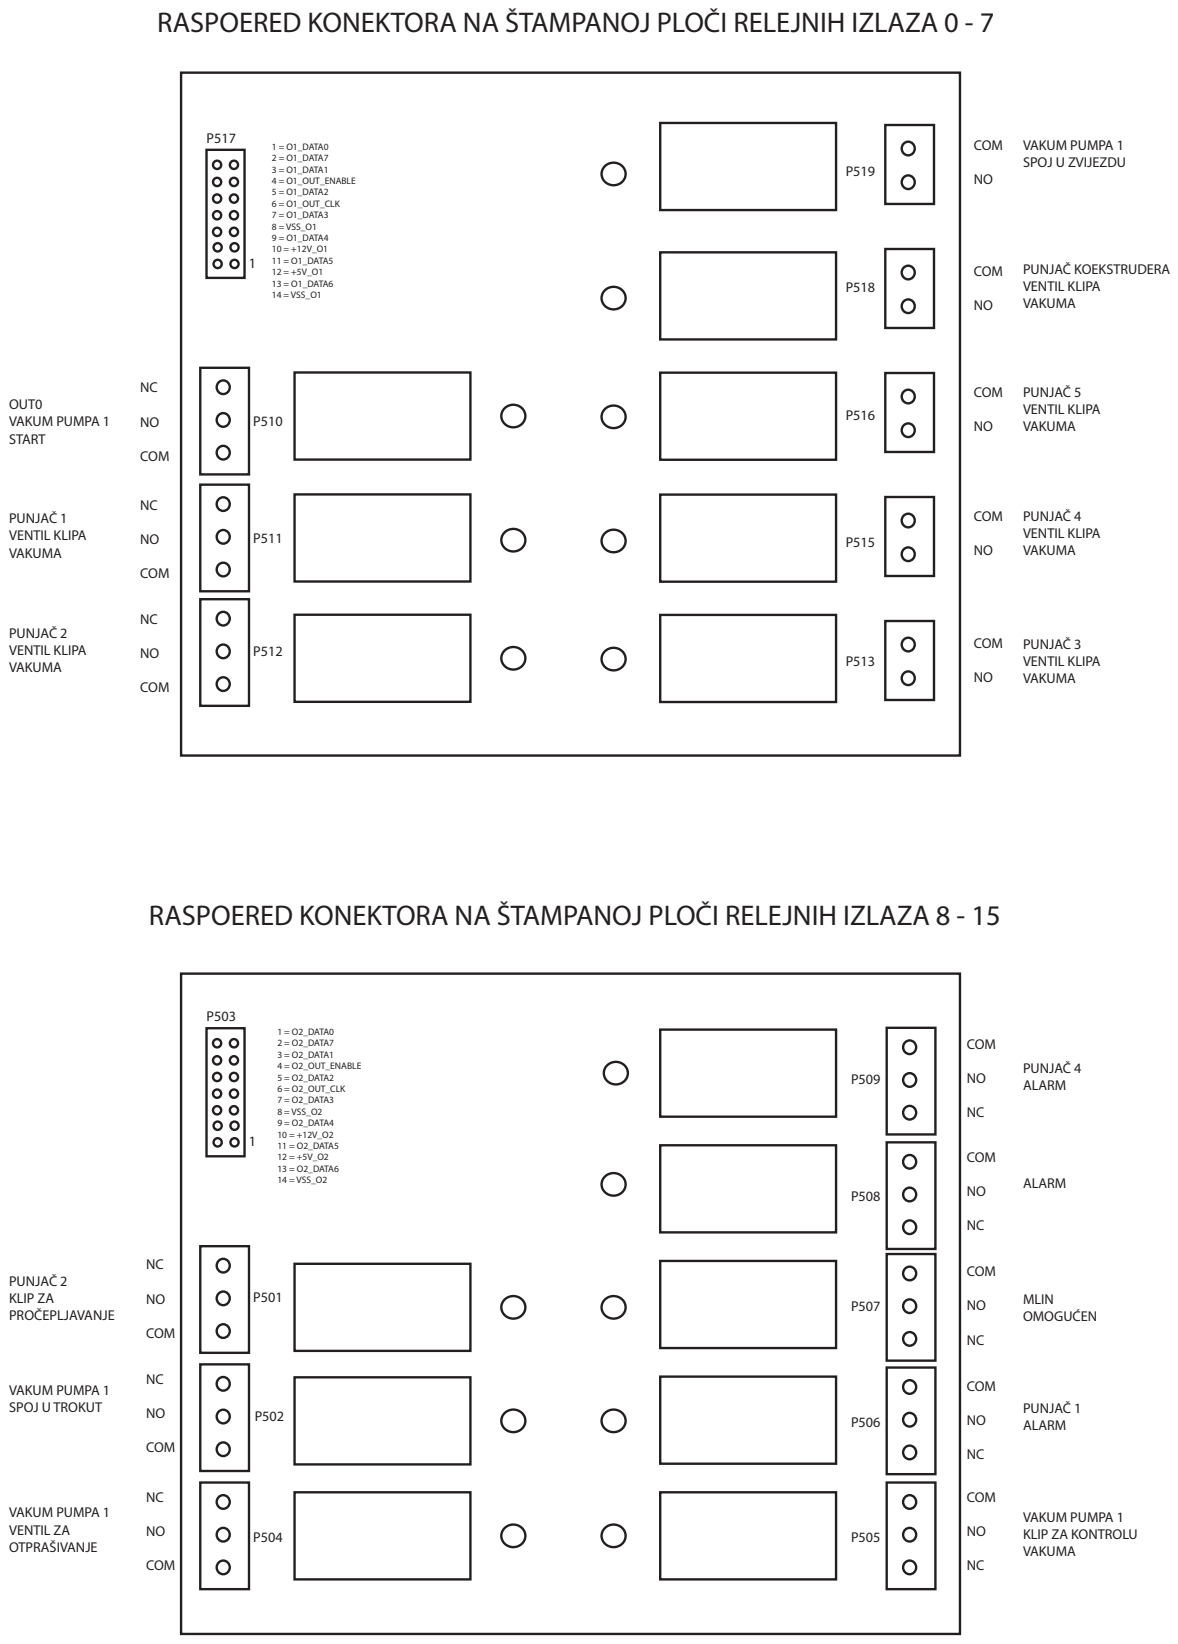
[picture p44: page 1]

RASPOERED KONEKTORA NA ŠTAMPANOJ PLOČI RELEJNIH IZLAZA 8 - 15
