eldar6776/Extruder-Raw-Material-Vacuum-Transport-Controller/doc/Raspored priključnica na štampanoj ploči kontrolera.pdf

# RASPORED KONEKTORA NA ŠTAMPANOJ PLOČI KONTROLERA

1 | 2 | 1 | 2 | 1 | 2 | 1 | 2 | 1 | 2

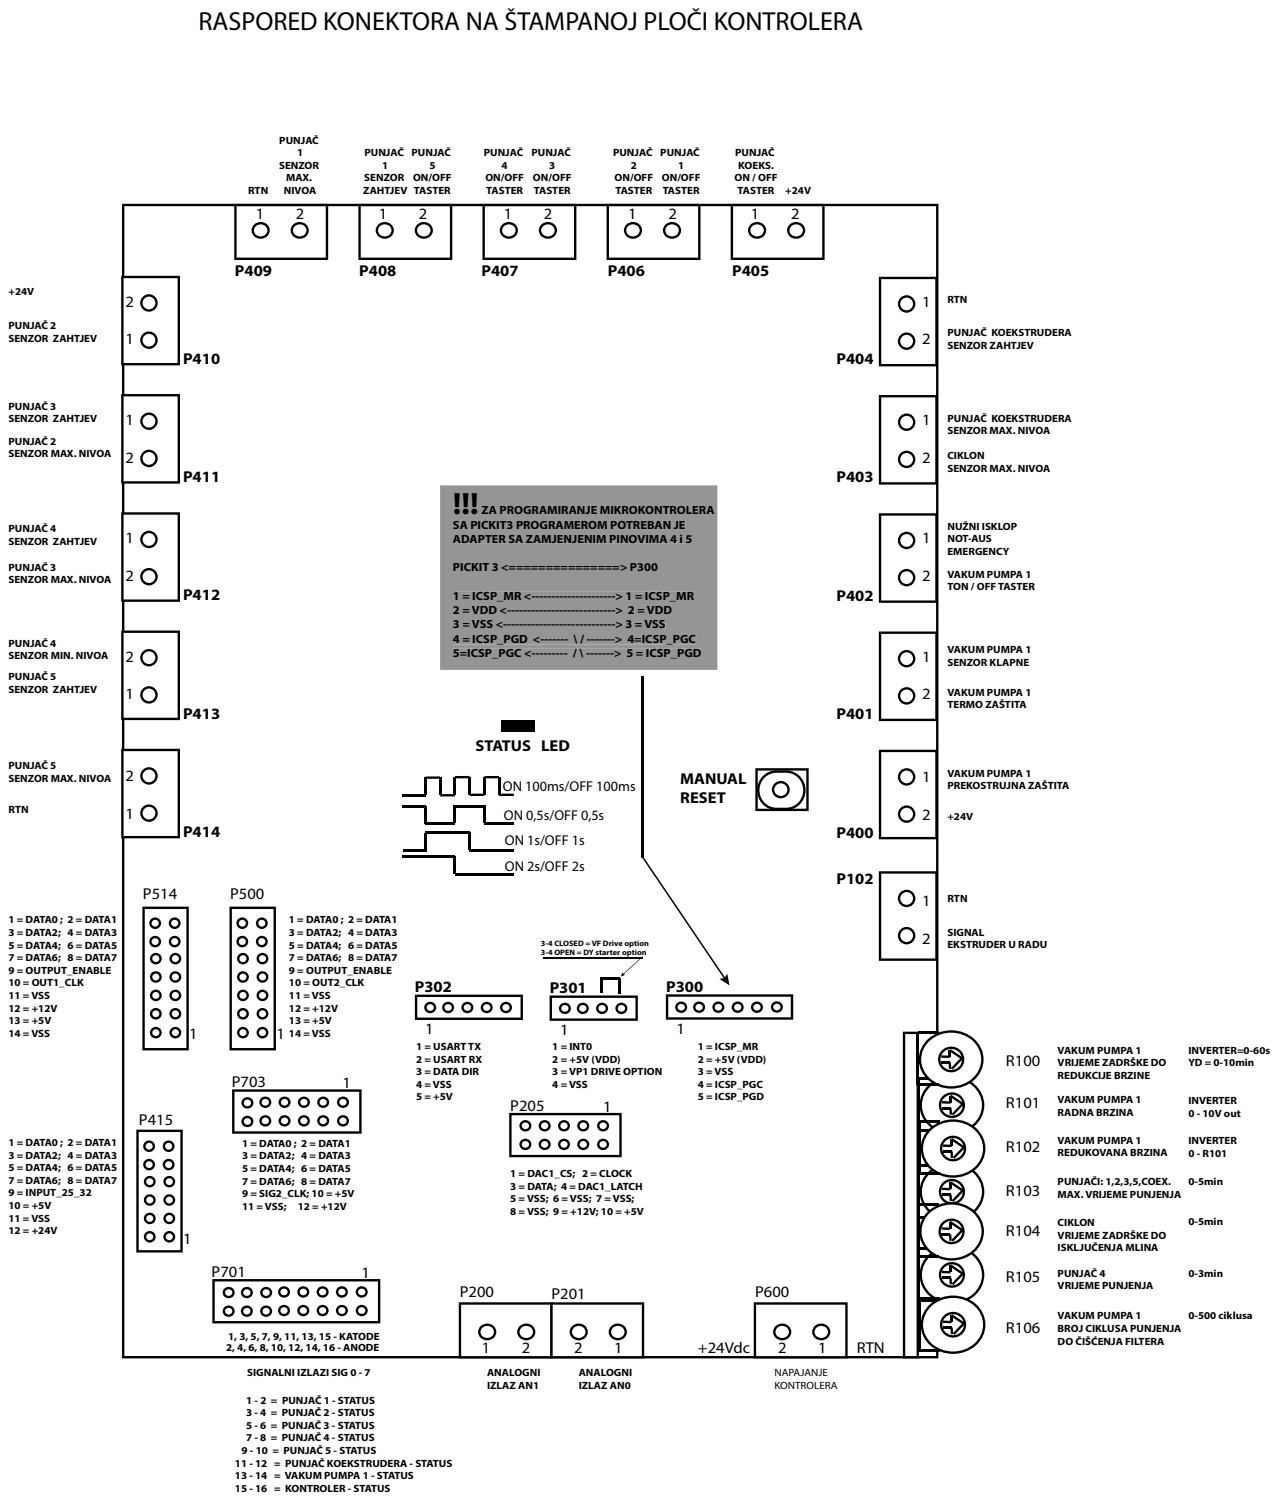
[picture p45: page 1]

SA PICKIT3 PROGRAMEROM POTREBAN JE
ADAPTER SA ZAMJENJENIM PINOVIMA 4 i 5

3-4 CLOSED = VF Drive option
3-4 OPEN = DY starter option
