eldar6776/Extruder-Raw-Material-Vacuum-Transport-Controller/doc/Raspored uređaja u elektroormaru.pdf

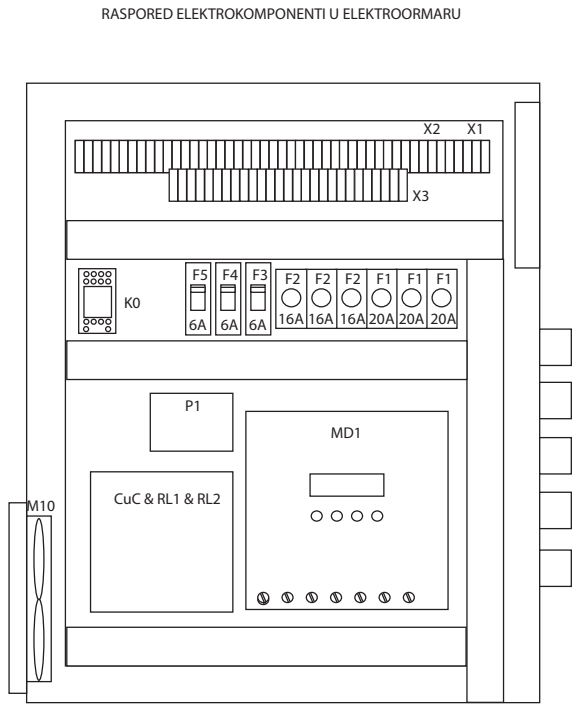
[picture p46: page 1]
CuC & RL1 & RL2 M10

RASPORED ELEKTROKOMPONENTI U ELEKTROORMARU
