eldar6776/Extruder-Raw-Material-Vacuum-Transport-Controller/(list of files, drawings)

Other design files:
hw/ANALOG_INPUT.SchDoc
hw/ANALOG_OUTPUT.SchDoc
hw/CUC.SchDoc
hw/DC SUPPLY.PcbDoc
hw/DC SUPPLY.PrjPcb
hw/DC SUPPLY.SchDoc
hw/DC SUPPLY.SchLib
hw/DC_SUPPLY.PcbLib
hw/DIGITAL_INPUT.SchDoc
hw/DIGITAL_OUTPUT.SchDoc
hw/ERROR_DISPLAY.SchDoc
hw/FINDER 40.31.PcbLib
hw/FINDER 40.31.SchLib
hw/KOTROLER_TRANSPORTA.PcbDoc
hw/KOTROLER_TRANSPORTA.PrjPcb
hw/PcbLib1.PcbLib
hw/PIHER POTI.PcbLib
hw/PIHER POTI.SchLib
hw/PSU.SchDoc
hw/SIGNAL_OUTPUT.SchDoc
hw/TERMINAL_CONNECOR_2.PcbLib
hw/TERMINAL_CONNECOR_2.SchLib
hw/TERMINAL_CONNECOR_3.PcbLib
hw/TERMINAL_CONNECOR_3.SchLib
